kevinkewang/lab_8010diadapter/images/IMG_2984.jpg

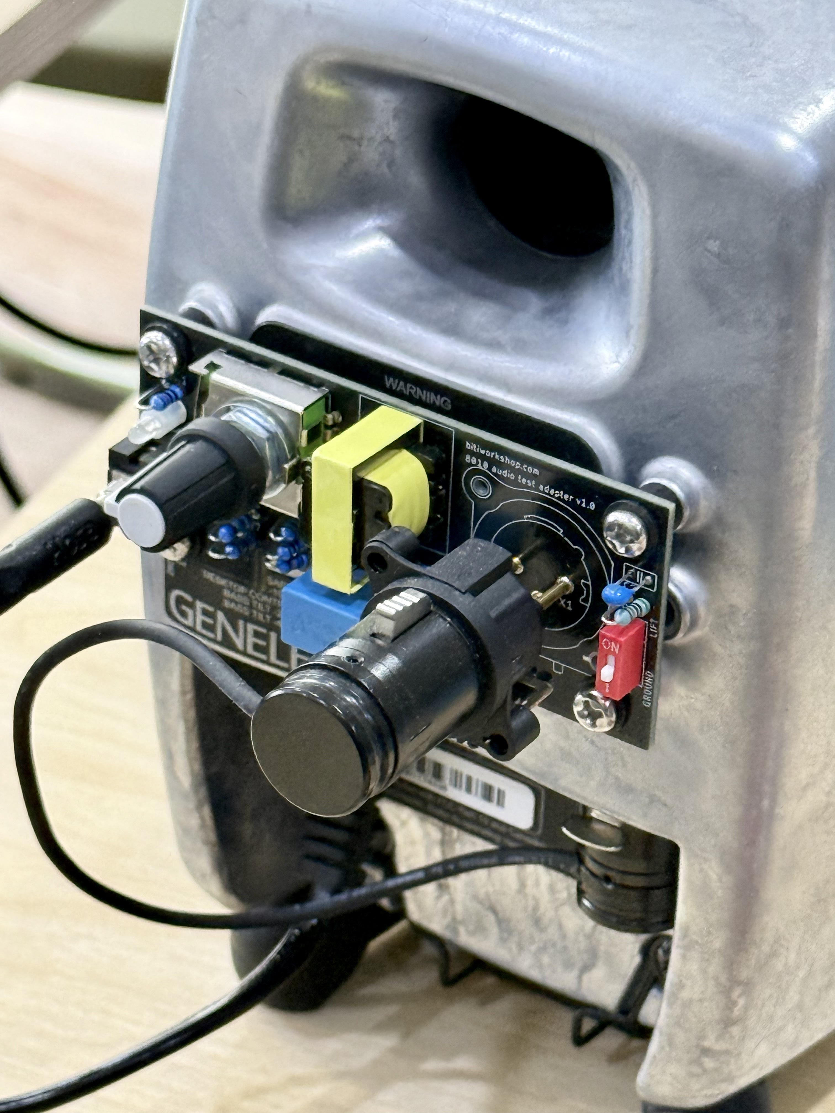
images/IMG_2984.jpg
