kevinkewang/lab_8010diadapter/images/IMG_2985.jpg

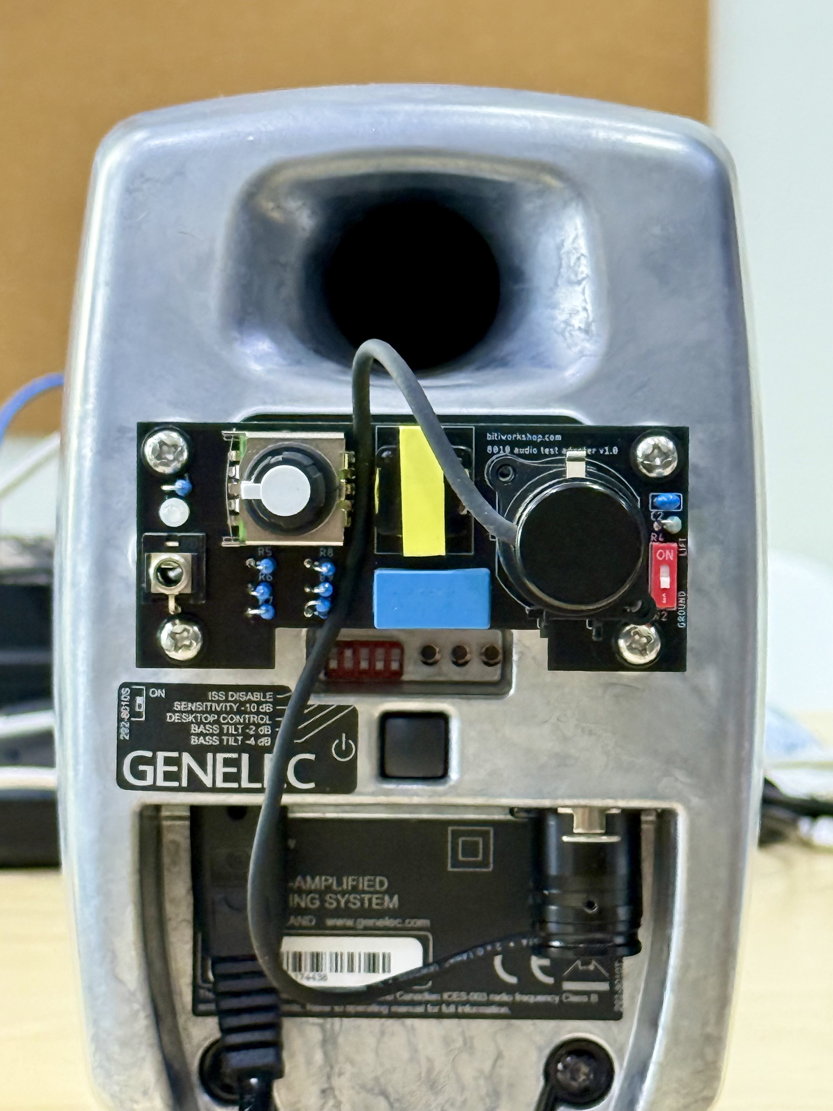
images/IMG_2985.jpg
