kevinkewang/lab_8010diadapter/hardware_design/circuit.pdf

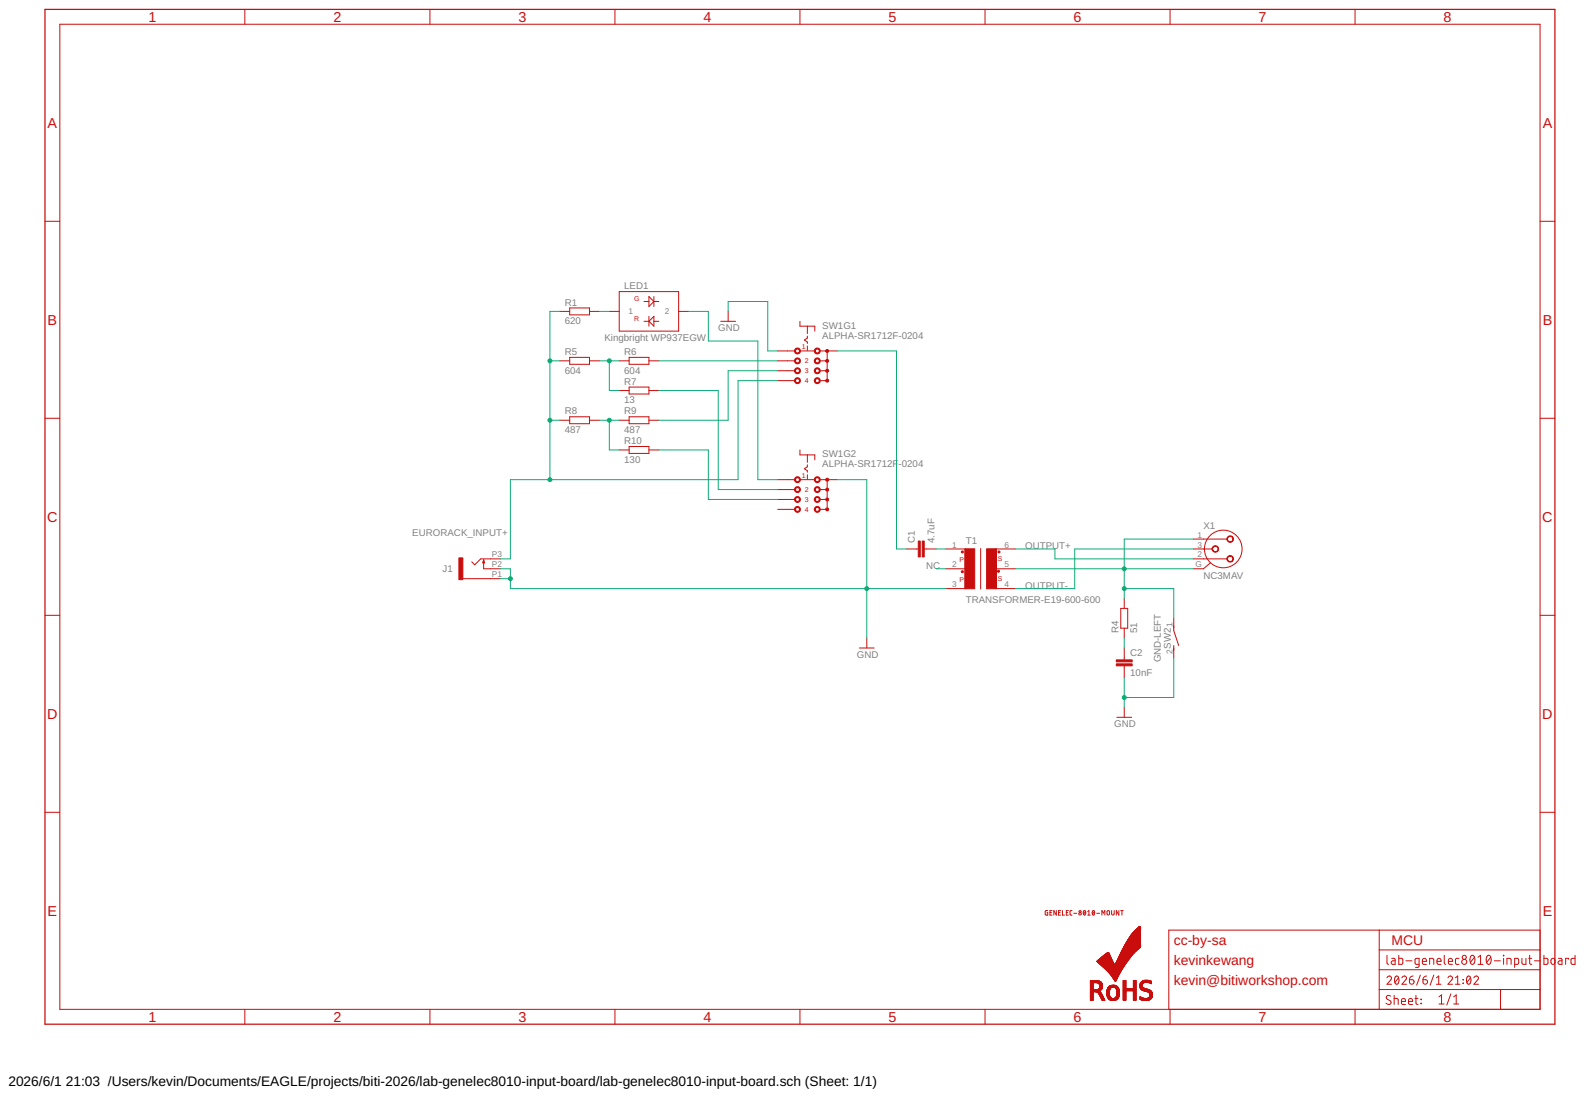
[picture p5: page 1]

2026/6/1 21:03 /Users/kevin/Documents/EAGLE/projects/biti-2026/lab-genelec8010-input-board/lab-genelec8010-input-board.sch (Sheet: 1/1)
