kevinkewang/lab_8010diadapter/hardware_design/eagle_pcb/lab-genelec8010-input-board-v10.brd

## EAGLE design hardware_design/eagle_pcb/lab-genelec8010-input-board-v10.brd (2026-11-12)

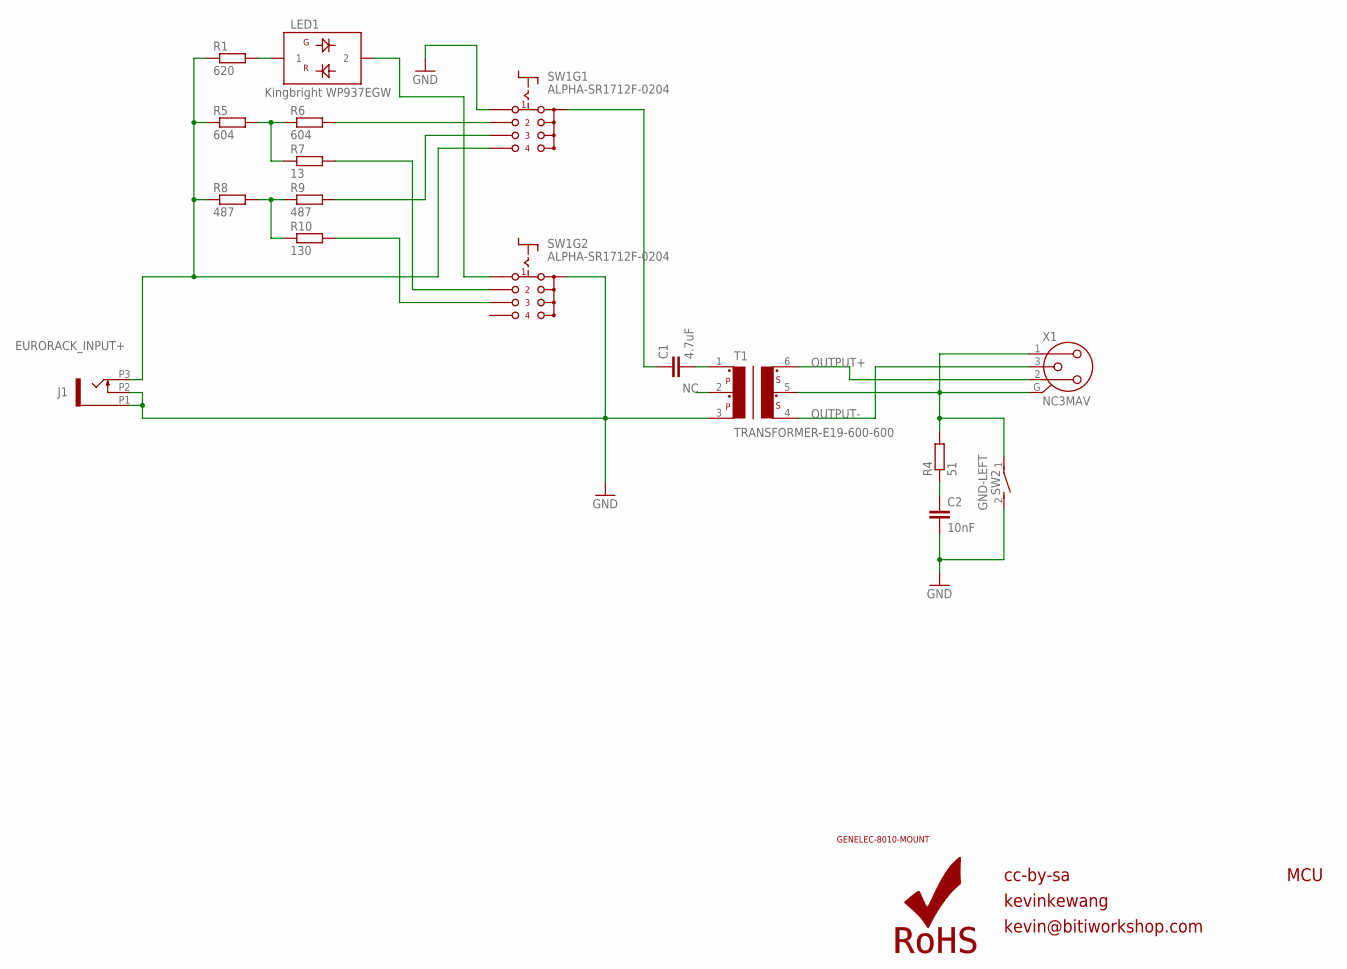
[picture p6: schematic lab-genelec8010-input-board-v10.sch]

Parts:
C1: 4.7uF; C15B5
C2: 10nF; C025-025X050
J1: OG-PJ301_PJ301_THONKICONN6; OG-PJ301_WQP_PJ_301M6
LED1: Kingbright WP937EGW; OG-LEDS_LED3MM
LOGO2: ROHS_LOGO; ROHS_LOGO_0.18_IN
R1: 620; 0204V
R4: 51; 0204V
R5, R6: 604; 0204V
R7: 13; 0204V
R8, R9: 487; 0204V
R10: 130; 0204V
SW1: ALPHA-SR1712F-0204
SW2: GND-LEFT; DS-01
T1: TRANSFORMER-E19-600-600
U$2: GENELEC-8010-MOUNT
X1: NC3MAV

Connections:
EURORACK_INPUT+: J1.P3 (3), R1.1, R5.1, R8.1, SW1.5 (4)
GND: C2.2, J1.P1 (1), J1.P2 (2), SW1.2 (1), SW1.COM10 (C), SW2.2, T1.3
unnamed: LED1.2, SW1.6 (1)
unnamed: LED1.1, R1.2
unnamed: C1.2, T1.1
unnamed: R5.2, R6.1, R7.1
unnamed: C2.1, R4.1
unnamed: R4.2, SW2.1, T1.5, X1.1, X1.G
unnamed: R6.2, SW1.3 (2)
unnamed: R7.2, SW1.7 (2)
unnamed: R8.2, R9.1, R10.1
unnamed: R9.2, SW1.4 (3)
unnamed: R10.2, SW1.8 (3)
unnamed: C1.1, SW1.COM1 (C)
NC: T1.2
OUTPUT+: T1.6, X1.2
OUTPUT-: T1.4, X1.3

Notes on the sheet:
cc-by-sa
MCU
kevinkewang
kevin@bitiworkshop.com

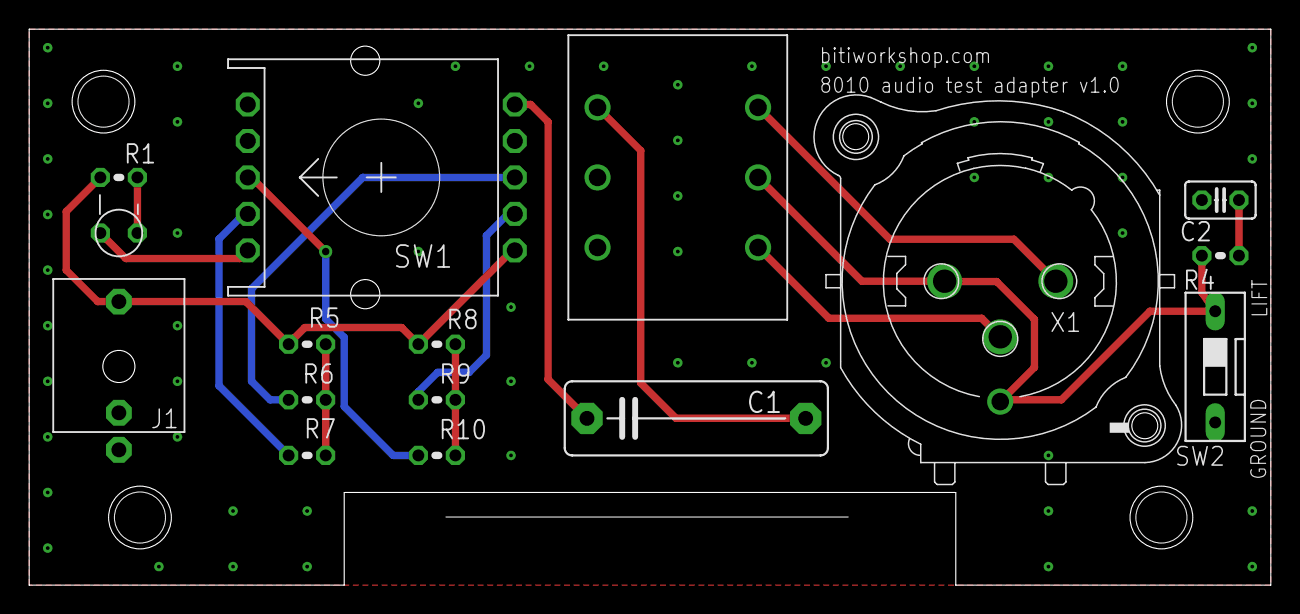
[picture p7: board lab-genelec8010-input-board-v10.brd from above]

Board: 2 copper layers, 85.1 x 38.1 mm, 18 parts (1 on the bottom side), 16 nets.
